meeseseang/Wireless_Rocket_Igniter/README.md

# Wireless_Rocket_Igniter
Wireless rocket ignition system based on the ESP32-S2 chip

## Features
- Line of sight usage
- ESP-NOW protocol
- Multiple safety measures
  - Lit toggle switches for power and arming
  - Double button push to verify launch
- Rechargeable battery system
- At least 3 hours of standby time on battery
