meeseseang/Wireless_Rocket_Igniter/Initial_BOM.png

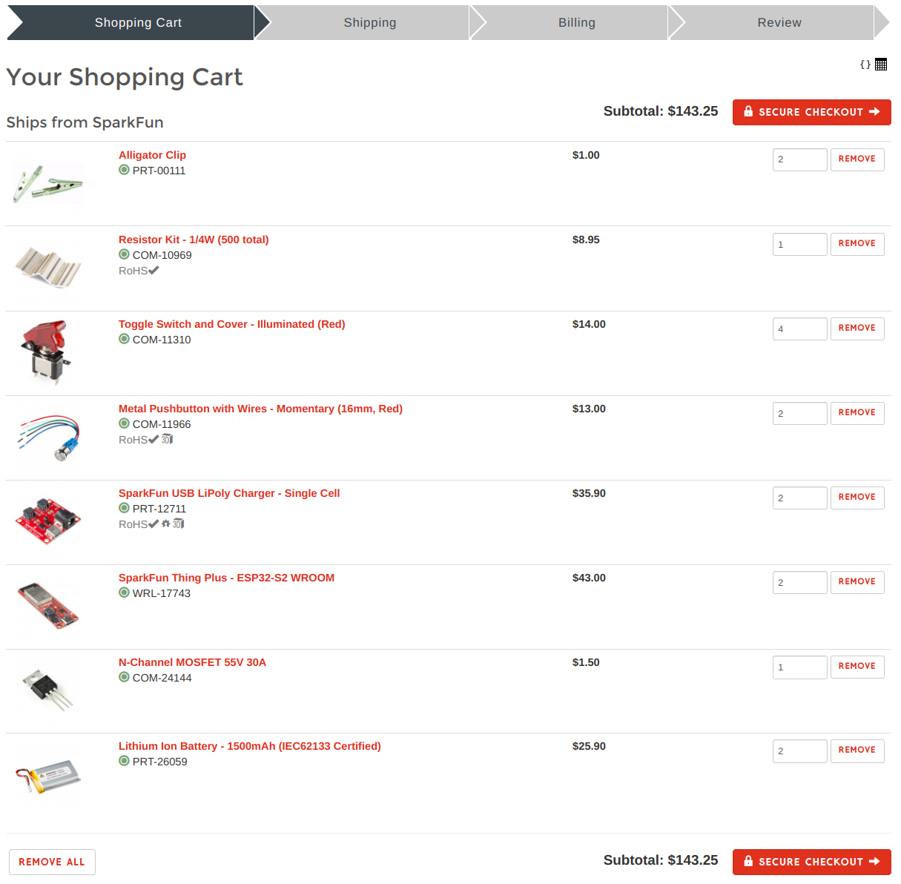
Initial_BOM.png
