meeseseang/Wireless_Rocket_Igniter/Control_Box/Control_Box_Schematic.pdf

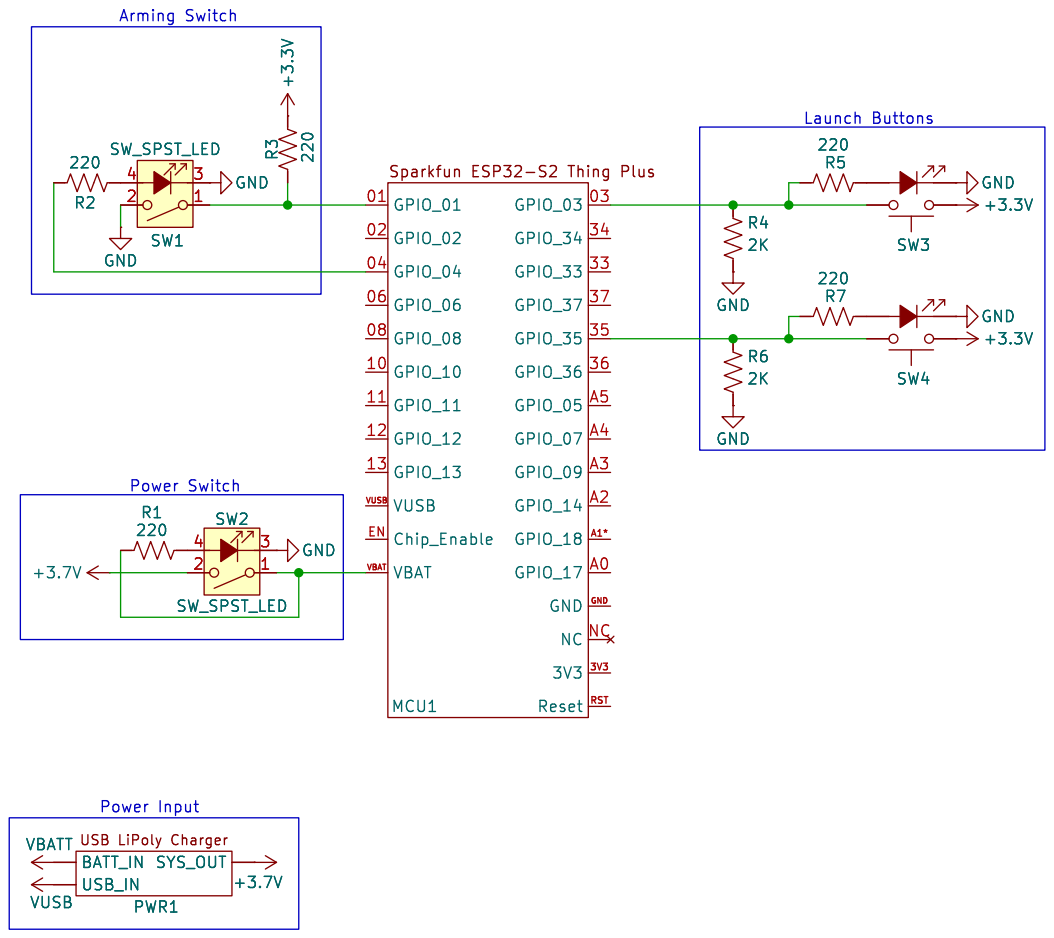
[picture p18: page 1]

File: Control_Box_KiCad.kicad_sch Sheet: /
Id: 1/1 Title: Wireless Rocket Ignition Control Box
