meeseseang/Wireless_Rocket_Igniter/Ignition_Box/Ignition_Box_KiCad.pdf

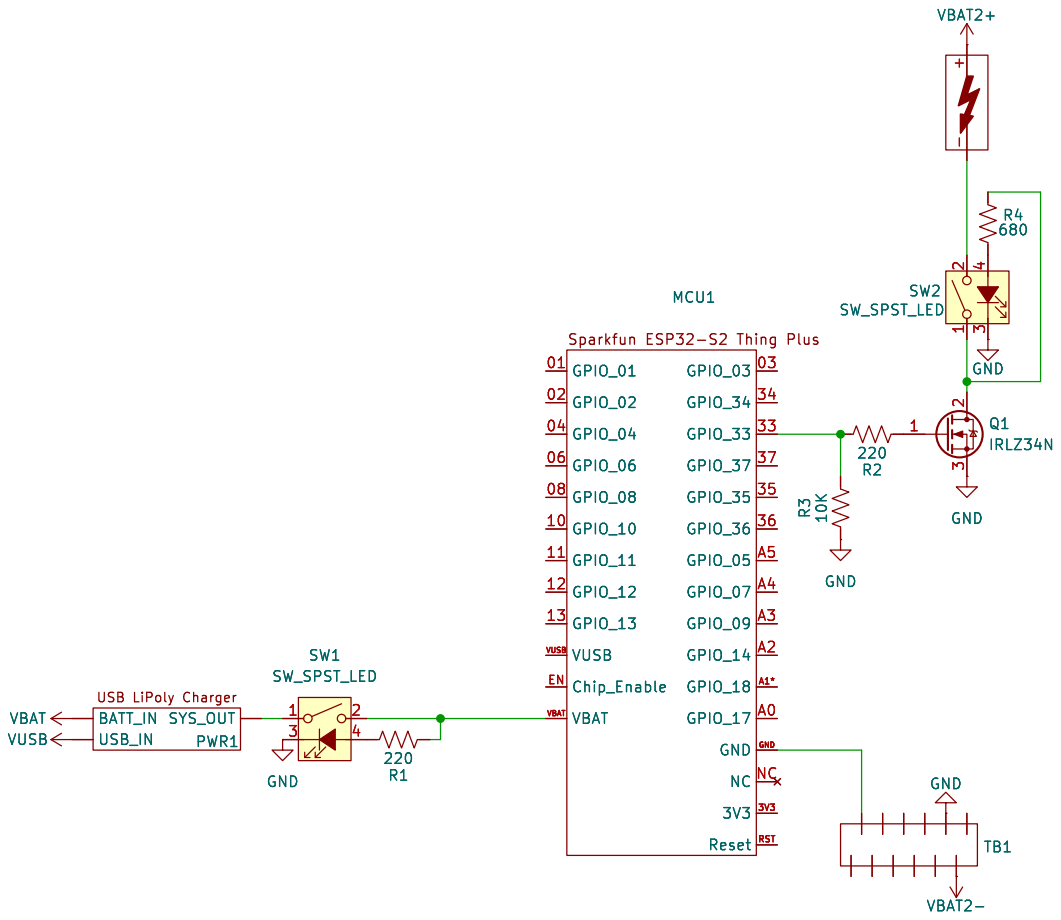
[picture p19: page 1]

Id: 1/1 Title: Wireless Rocket Ignition System - Ignition Box
