meeseseang/Wireless_Rocket_Igniter/KiCad_Extra_Files/SparkFun-KiCad-Libraries-1.1/Pre_v7/Documentation/Example Project/boostboard1.kicad_pcb

## KiCad design KiCad_Extra_Files/SparkFun-KiCad-Libraries-1.1/Pre_v7/Documentation/Example Project/boostboard1.kicad_pcb (2024-12-28)



Board: 2 copper layers, 15.2 x 15.2 mm, 21 parts (3 on the bottom side), 9 nets.

Parts:
C1, C2, C3: 22UF-0805-6.3V-20%; 0805
D1: LED-RED0603; LED-0603
FD1, FD2: FIDUCIAL1X2; FIDUCIAL-1X2
H1: STAND-OFF
J1, J3: CONN_02; 1X02
J2: CONN_01; 1X01
JP1: JUMPER-SMT_2_NO; SMT-JUMPER_2_NO_SILK
L1: INDUCTOR-CDRH-4.7UH; INDUCTOR_2.2UH
LOGO1: SFE_LOGO_NAME_FLAME.1_INCH; SFE_LOGO_NAME_FLAME_.1
LOGO2: OSHW-LOGOS; OSHW-LOGO-S
R1: 10KOHM-0603-1_10W-1%; 0603
R2, R4: 100KOHM-0603-1_10W-1%; 0603
R3, R5: 820KOHM-0603-1_10W-1%; 0603
R6: 4.7KOHM-0603-1_10W-1%; 0603
U1: PAM2401; MSOP8

Connections:
/EN: J2.1, R1.2, U1.2
/FB: JP1.2, R3.1, R4.2, U1.5
/GND: C1.2, C2.2, C3.2, J1.1, J3.1, R2.2, R4.1, R6.1, U1.4, U1.8
/LX: L1.P$2, U1.1
/RSET: R2.1, U1.6
/VBATT: C1.1, J1.2, L1.P$1, R1.1, U1.3
/VCC: C2.1, C3.1, D1.A, J3.2, R3.2, R5.2, U1.7
unnamed: D1.C, R6.2
unnamed: JP1.1, R5.1
