meeseseang/Wireless_Rocket_Igniter/KiCad_Extra_Files/SparkFun_LiPo_Charger_Plus/SparkFun_LiPo_Charger_Plus.brd

## EAGLE design KiCad_Extra_Files/SparkFun_LiPo_Charger_Plus/SparkFun_LiPo_Charger_Plus.brd (2024-12-28)

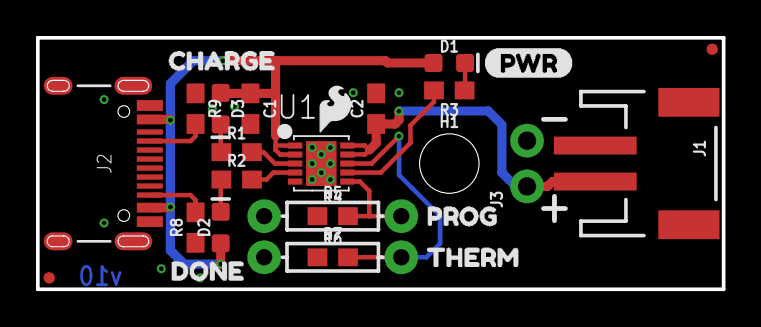
[picture p22: board SparkFun_LiPo_Charger_Plus.brd from above]

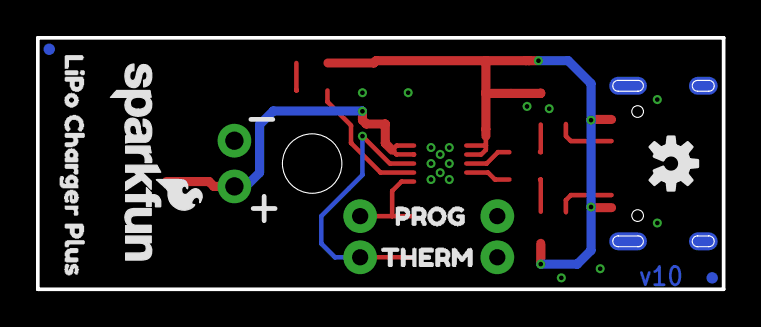
[picture p23: board SparkFun_LiPo_Charger_Plus.brd from below]

Board: 2 copper layers, 38.1 x 14.0 mm, 35 parts (7 on the bottom side), 13 nets.

Parts:
C1, C2: 10uF; 0603
D1: RED; LED-0603
D2: GREEN; LED-0603
D3: Yellow; LED-0603
FD1, FD2, FD3, FD4: FIDUCIALUFIDUCIAL; FIDUCIAL-MICRO
FRAME1: FRAME-LETTER; CREATIVE_COMMONS
H1: STAND-OFF
J1: JST-2-SMD
J2: USB-C-16P
J3: 1X02_NO_SILK
LOGO1: SFE_LOGO_NAME_FLAME.1_INCH; SFE_LOGO_NAME_FLAME_.1
LOGO2: OSHW-LOGOS; OSHW-LOGO-S
R1, R2, R3: 1.5k; 0603
R4: 1k; 0603
R5: PROG; AXIAL-0.3
R6: 10k; 0603
R7: THERM; AXIAL-0.3
R8, R9: 5.1k; 0603
U1: MCP73833; DFN-10
U$1: SFE_LOGO_FLAME_.1
U$2, U$5: PROG7
U$3: CHARGE3
U$4: DONE4
U$6, U$8: THERM8
U$7: PWR6
U$9: LIPO_CHARGER_PLUS0

Connections:
GND: C1.2, C2.2, J1.1, J2.GND, J2.GND2, J2.SHLD1, J2.SHLD2, J2.SHLD3, J2.SHLD4, J2.SHLD5, J2.SHLD6, J2.SHLD7, J2.SHLD8, J3.2, R4.1, R5.P$1, R6.1, R7.P$1, R8.1, R9.1, U1.P$5, U1.P$11
unnamed: D1.C, R3.1
unnamed: D2.C, R2.1
unnamed: D3.C, R1.1
unnamed: J2.B5, R8.2
unnamed: J2.A5, R9.2
PG: R3.2, U1.P$7
PROG: R4.2, R5.P$2, U1.P$6
STAT1: R1.2, U1.P$3
STAT2: R2.2, U1.P$4
THERM: R6.2, R7.P$2, U1.P$8
VDD: C1.1, D1.A, D2.A, D3.A, J2.VBUS1, J2.VBUS2, U1.P$1, U1.P$2
V_BATT: C2.1, J1.2, J3.1, U1.P$9, U1.P$10
