meeseseang/Wireless_Rocket_Igniter/KiCad_Extra_Files/ESP32-S2_thing_plus_eagle_files/ESP32-S2_Thing_Plus.brd

## EAGLE design KiCad_Extra_Files/ESP32-S2_thing_plus_eagle_files/ESP32-S2_Thing_Plus.brd (2024-12-28)

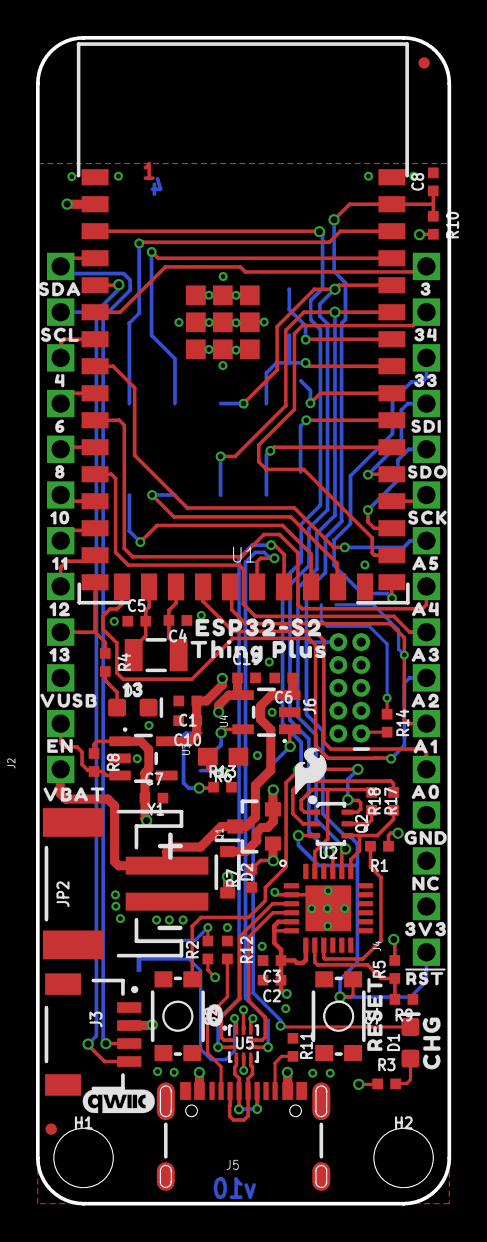
[picture p24: board ESP32-S2_Thing_Plus.brd from above]

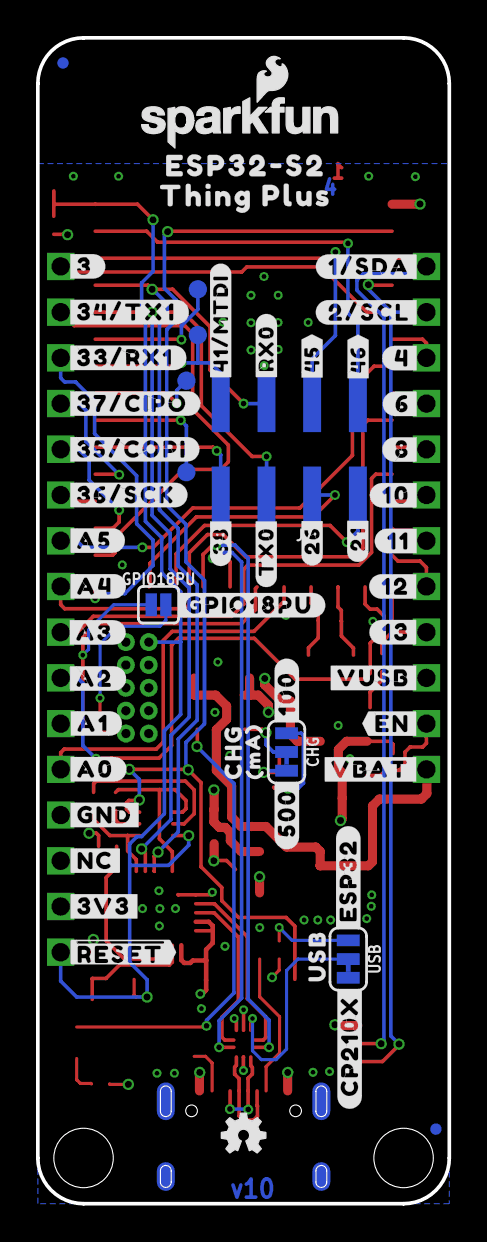
[picture p25: board ESP32-S2_Thing_Plus.brd from below]

Board: 4 copper layers, 22.9 x 64.8 mm, 147 parts (58 on the bottom side), 65 nets.

Parts:
C1: 10uF; 0402-TIGHT
C2, C8: 0.1uF; 0402-TIGHT
C3, C6, C19: 4.7uF; 0402-TIGHT
C4, C5: 15pF; 0402-TIGHT
C7, C10: 1.0uF; 0402-TIGHT
CHG: SMT-JUMPER_3_1-NC_TRACE_SILK
D1: Yellow; LED-0603
D2: 1A/23V/620mV; SOD-323
D3: BLUE; LED-0603
FD1, FD2, FD3, FD4: FIDUCIALUFIDUCIAL; FIDUCIAL-MICRO
FRAME1: FRAME-LEDGER; CREATIVE_COMMONS
GPIO18PU: SMT-JUMPER_2_NO_SILK
H1, H2: STAND-OFF
J2: 1X12_SM_SQ_NOSILK
J3: QWIIC_RA; JST04_1MM_RA
J4: 1X16_SM_SQ_NOSILK
J5: USB-C; USB-C-16P-4LAYER-ISOLATED
J6: JTAG; 2X5-PTH-1.27MM-NO_SILK
J7: 2X4_SMT_NO_POSTS_NS
JP2: LiPo; JST-2-SMD
LOGO1: SFE_LOGO_FLAME.1_INCH; SFE_LOGO_FLAME_.1
LOGO2: OSHW-LOGOMINI; OSHW-LOGO-MINI
LOGO3: SFE_LOGO_NAME_FLAME.1_INCH; SFE_LOGO_NAME_FLAME_.1
LOGO4: FOUR_LAYER_WARNING
LOGO6: QWIIC_LOGO_4MM; QWIIC_4MM
Q1: 2.5A/30V; SOT23-3@1
Q2: MBT3904DW1T1; SC70-6
R1, R2, R7, R10, R13, R14, R17, R18: 10k; 0402-TIGHT
R3, R4: 1k; 0402-TIGHT
R5: 22k; 0402-TIGHT
R6: 2.0k; 0603
R8: 100k; 0402-TIGHT
R9: 33k; 0402-TIGHT
R11, R12: 5.1k; 0402-TIGHT
S1: RESET; TACTILE_SWITCH_SMD_4.6X2.8MM
S2: 0; TACTILE_SWITCH_SMD_4.6X2.8MM
TP1: TP_15TH
TP2, TP3, TP4, TP5: PAD.03X.04
U1: ESP32-S2-WROOM
U2: CP210X; QFN24
U3: AP2112; SOT23-5
U4: MCP73831; SOT23-5
U5: TC7USB40MU; UQFN10
U$1: #CP210X#0
U$2: SDI0
U$3, U$78: CHG0
U$4: #500#0
U$5: ESP32#S20
U$6: SDO0
U$7: #RST#0
U$8: #46#0
U$9: #ESP32#0
U$10: #45#0
U$11: MA0
U$12: #A5#0
U$14: USB0
U$15: 110
U$16: #GPIO18PU#0
U$17: 100
U$18: 80
U$19: #A4#0
U$20: 60
U$21: #A2#0
U$22: #A3#0
U$23: 40
U$24: 330
U$25: SDA0
U$26: SCL0
U$28: #A0#0
U$29: 340
U$30: 30
U$31: #36#SCK#0
U$32: #GND#0
U$33: #35#COPI#0
U$34: #37#CIPO#0
U$35: #33#RX1#0
U$36: #34#TX1#0
U$37: #3#0
U$38: #41#MTDI#0
U$39: #12#0
U$40: #13#0
U$41: #VUSB#0
U$42: #VBAT#0
U$43: #EN#0
U$44: #NC#0
U$45: #3V3#0
U$46: ##RESET##0
U$47: #11#0
U$48: #6#0
U$49: #8#0
U$50: #10#0
U$51: #4#0
U$52: #1#SDA#0
U$53: #2#SCL#0
U$54: #21#0
U$55: #26#0
U$56: #TX0#0
U$57: #38#0
U$58: #RX0#0
U$59: ORDERING_INSTRUCTIONS
U$60: #100#0
U$61: THING_PLUS0
U$62: THING_PLUS_0
U$63: ESP32#S2_0
U$64: #A1#0
U$72: 120
U$73, U$74: 130
U$75: VUSB0
U$76: EN0
U$77: VBAT0
U$79: RESET0
U$81: 3V30
U$82: NC0
U$83: GND0
U$84: A00
U$85: A10
U$86: A20
U$87: A30
U$88: A40
U$89: A50
U$90: SCK0
U$96: 00
USB: SMT-JUMPER_3_1-NC_TRACE_SILK
Y1: 32.768kHz; CRYSTAL-SMD-3.2X1.5MM

Connections:
0: Q2.6, S2.4, TP1.P$1, U1.3
3: J4.16, U1.6
3.3V: C1.1, C2.1, C3.1, C10.1, J3.2, J4.2, J6.1, R1.1, R2.1, R10.2, R14.2, U1.2, U2.5, U2.6, U2.7, U3.5, U5.9
4: J2.10, U1.7
6: J2.9, U1.9
8: J2.8, U1.11
10: J2.7, U1.13
11: J2.6, U1.14
12: J2.5, U1.15
13: J2.4, R4.1, U1.16
21: J7.2, U1.24
26: J7.4, U1.25
33/RX1: J4.14, U1.27
34/TX1: J4.15, U1.28
38: J7.8, U1.32
41/MTDI: J6.8, J7.7, TP2.P$1, U1.35
45: J7.3, U1.39
46: J7.1, U1.40
A0: J4.5, U1.20
A1: GPIO18PU.1, J4.6, U1.21
A2: J4.7, U1.17
A3: J4.8, U1.12
A4: J4.9, U1.10
A5: J4.10, U1.8
CC1: J5.A5, R12.2
CC2: J5.B5, R11.2
CHG: D1.C, U4.1
CHIP_PU: C8.1, J4.1, J6.10, Q2.3, R10.1, S1.4, U1.41
CIPO: J4.13, U1.31
COPI: J4.12, U1.29
CP210X_D+: U2.3, U5.1
CP210X_D-: U2.4, U5.7
DTR: Q2.1, R17.1, U2.23
EN: J2.2, R8.2, U3.3
ESP32_D+: U1.23, U5.2
ESP32_D-: U1.22, U5.6
GND: C1.2, C2.2, C3.2, C4.1, C5.1, C6.2, C7.2, C8.2, C10.2, C19.2, D3.C, J3.1, J4.4, J5.GND, J5.GND2, J6.3, J6.5, J6.7, J6.9, JP2.1, R6.1, R7.1, R9.1, R11.1, R12.1, R13.2, S1.1, S2.1, U1.1, U1.26, U1.42, U1.GNDEP0, U1.GNDEP1, U1.GNDEP2, U1.GNDEP3, U1.GNDEP4, U1.GNDEP5, U1.GNDEP6, U1.GNDEP7, U1.GNDEP8, U2.2, U2.PAD, U3.2, U4.2, U5.4, U5.8, USB.3
MTCK: J6.4, TP4.P$1, U1.33
MTDO: J6.6, TP3.P$1, U1.34
MTMS: J6.2, TP5.P$1, U1.36
unnamed: R1.2, U2.9
unnamed: D3.A, R4.2
unnamed: J5.A6, J5.B6, U5.3
unnamed: R5.1, R9.2, U2.8
unnamed: J5.A7, J5.B7, U5.5
unnamed: R2.2, USB.1
unnamed: C5.2, U1.18, Y1.P$2
unnamed: C4.2, U1.19, Y1.P$1
unnamed: CHG.2, U4.5
unnamed: Q2.5, R17.2
unnamed: CHG.1, R13.1
unnamed: Q2.2, R18.2
unnamed: CHG.3, R6.2
unnamed: GPIO18PU.2, R14.1
unnamed: D1.A, R3.2
RTS: Q2.4, R18.1, U2.19
RX0: J7.5, U1.38, U2.21
SCK: J4.11, U1.30
SCL: J2.11, J3.4, U1.5
SDA: J2.12, J3.3, U1.4
TX0: J7.6, U1.37, U2.20
USB_SEL: U5.10, USB.2
VIN: C7.1, D2.C, Q1.2, R8.1, U3.1
V_BATT: C6.1, J2.1, JP2.2, Q1.3, U4.3
V_USB: C19.1, D2.A, J2.3, J5.VBUS1, J5.VBUS2, Q1.1, R3.1, R5.2, R7.2, U4.4
