meeseseang/Wireless_Rocket_Igniter/Control_Box/Control_Box_KiCad/Control_Box_KiCad.kicad_sch

## KiCad design Control_Box/Control_Box_KiCad/Control_Box_KiCad.kicad_sch (2024-12-28)

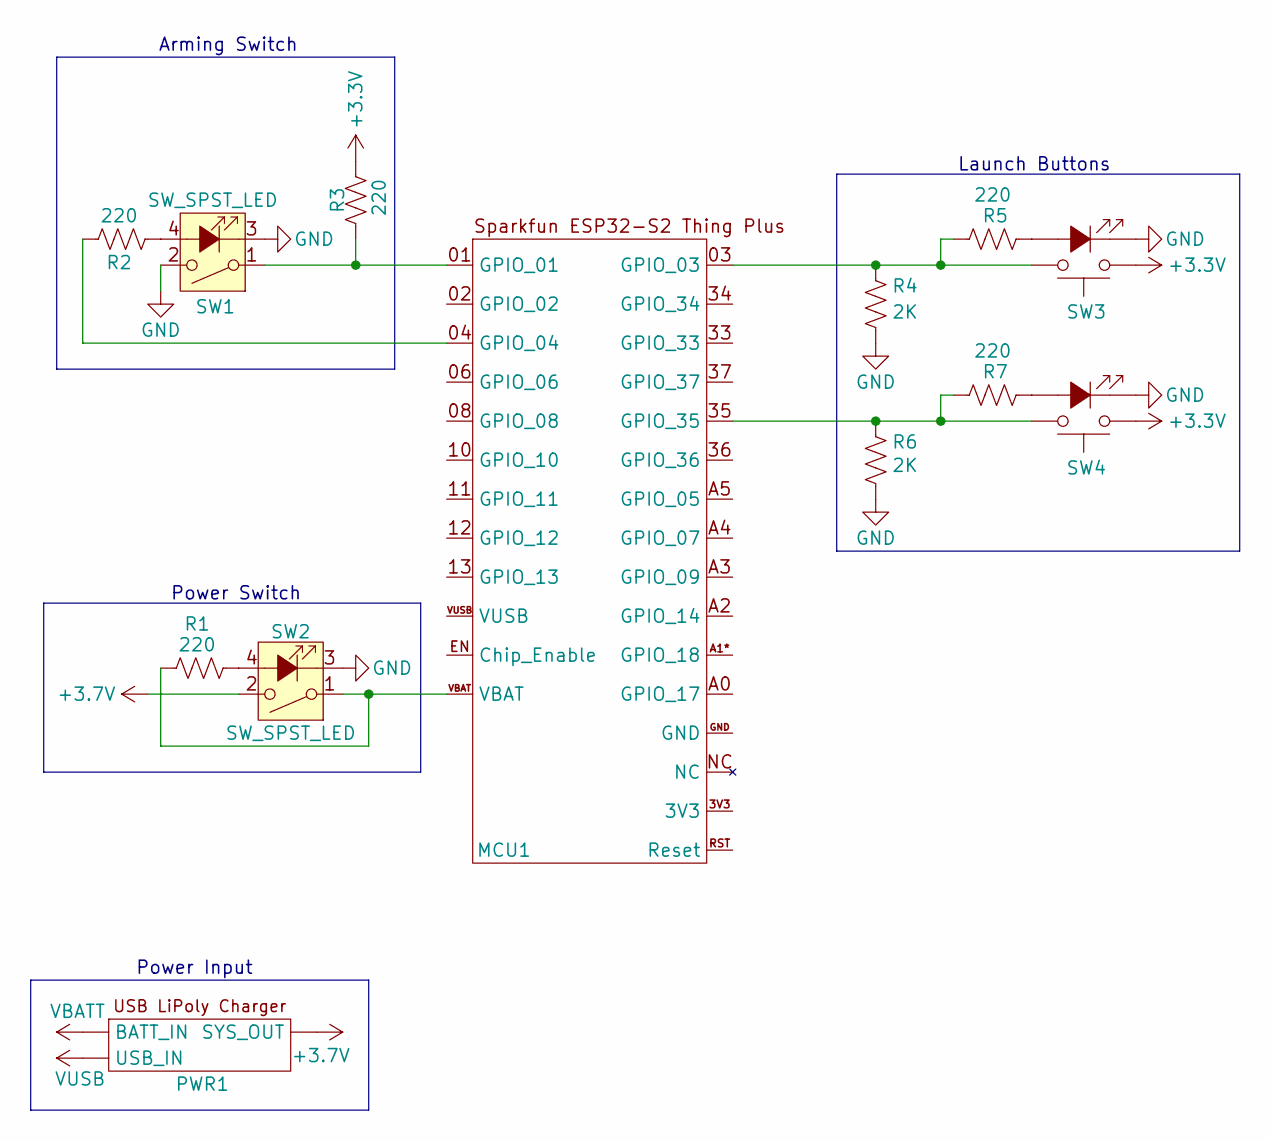
[picture p26: schematic Control_Box_KiCad.kicad_sch]

Parts:
MCU1: (no value)
PWR1: (no value)
R1, R2, R3, R5, R7: 220
R4, R6: 2K
SW1, SW2: SW_SPST_LED
SW3, SW4: Red; Push_PTH_12x12mm_LED; Mfg Part# TSL-012 (Red)

Connections:
+3.3V: R3.1, SW3.1, SW4.1
+3.7V: PWR1., SW2.2
GND: R4.2, R6.2, SW1.2, SW1.3 (K), SW2.3 (K), SW3.K, SW4.K
unnamed: MCU1.01 (GPIO_01), R3.2, SW1.1
unnamed: MCU1.03 (GPIO_03), R4.1, R5.2, SW3.2
unnamed: MCU1.04 (GPIO_04), R2.1
unnamed: MCU1.35 (GPIO_35), R6.1, R7.2, SW4.2
unnamed: MCU1.VBAT, R1.1, SW2.1
unnamed: R1.2, SW2.4 (A)
unnamed: R2.2, SW1.4 (A)
unnamed: R5.1, SW3.A
unnamed: R7.1, SW4.A
VBATT: PWR1.
VUSB: PWR1.

Notes on the sheet:
Arming Switch
Power Input
Power Switch
Launch Buttons
