meeseseang/Wireless_Rocket_Igniter/(commit log)

2024-12-28 Created schematic for control box
    [Control_Box_KiCad.kicad_pcb, Control_Box_KiCad.kicad_sch]
2024-12-28 Extra library files for KiCad
    [ESP32-S2_Thing_Plus.brd, SparkFun_LiPo_Charger_Plus.brd, _saved_boostboard1.sch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]
2024-12-28 Initial BOM based on control box design
2024-12-28 Initial creation of ignition box files
    [Ignition_Box_KiCad.kicad_pcb, Ignition_Box_KiCad.kicad_sch]
2024-12-28 Removed unnecessary schematic file
2024-12-28 Finished initial schematic of ignition box
    [Ignition_Box_KiCad.kicad_sch]
2024-12-31 Created initial prototype of code for the boxes
