meeseseang/Wireless_Rocket_Igniter/(notices)

Notices in the files:
KiCad_Extra_Files/SparkFun-KiCad-Libraries-1.1/Pre_v7/Documentation/Example Project/_saved_boostboard1.sch:
Released under the Creative Commons share-Alike 4.0
parts and their libraries:
SparkFun-Resistors: Licensing: Creative Commons ShareAlike 4.0 International - https://creativecommons.org/licenses/by-sa/4.0
SparkFun-Aesthetics: Released under the Creative Commons Attribution Share-Alike 4.0 License
SparkFun-Aesthetics: https://creativecommons.org/licenses/by-sa/4.0
